aerospace-venoms/BCCC_Temperature_SAO/(notices)

Notices in the files:
hardware/bccc_sao_rp2350a/bccc_sao_rp2350a.kicad_pcb:
v1.5 June 2026. WTF Public License
